nmaas87/wiznet-rp2040-sensor/Hardware/Schematic_rp2040_2022-02-07.pdf

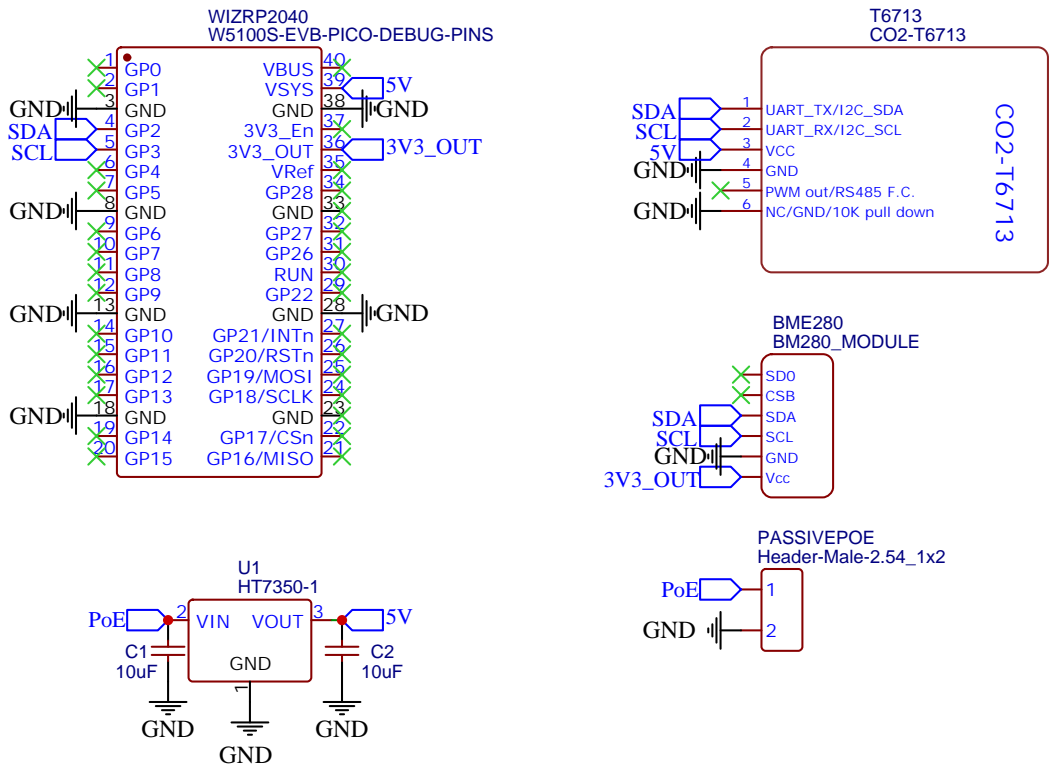
[picture p5: page 1]

WIZRP2040
W5100S-EVB-PICO-DEBUG-PINS

Drawn By: Nico Maas
