nmaas87/wiznet-rp2040-sensor/Hardware/PCB_PCB_rp2040_2022-02-07.pdf

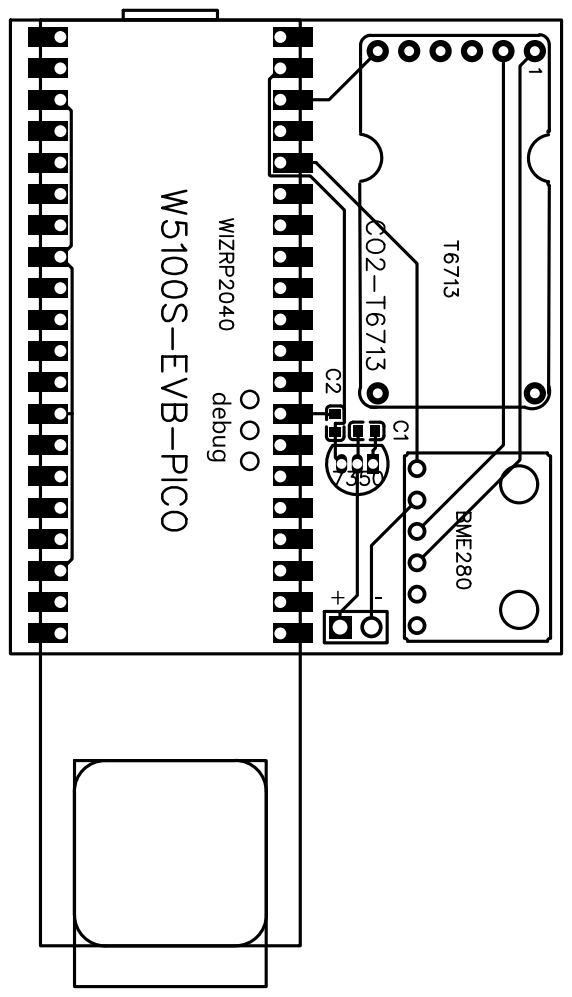
[picture p6: page 1]
